glmoritz/labsc-radioenge-bluepill/output/lora-bluepill-sch.pdf

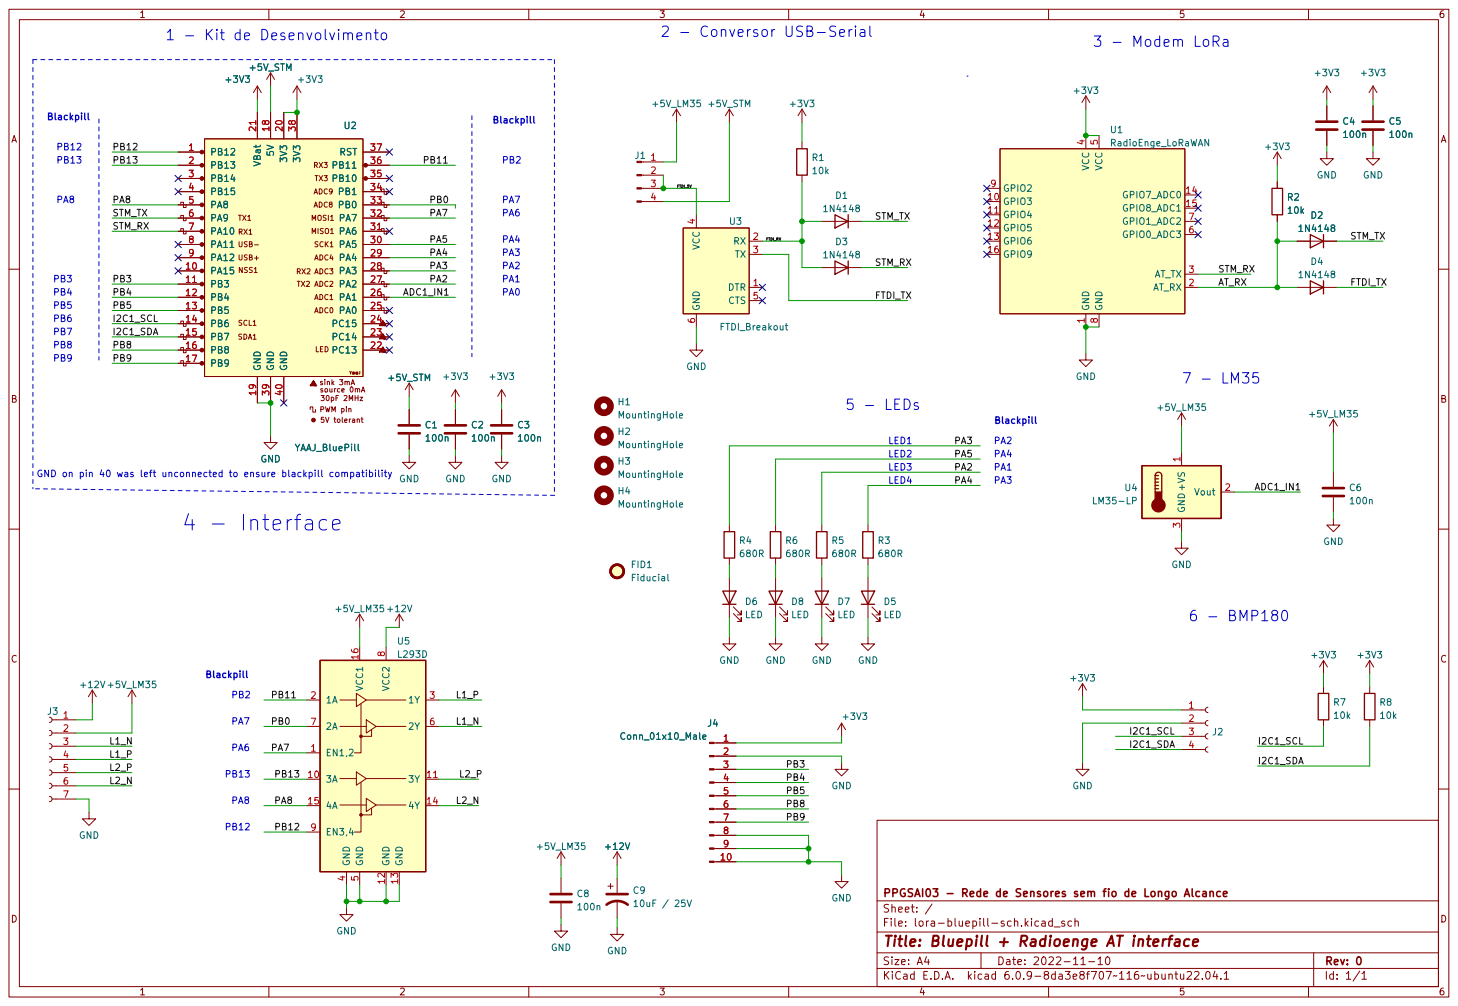
[picture p1: page 1]

LED4 PA8 GND on pin 40 was left unconnected to ensure blackpill compatibility

File: lora-bluepill-sch.kicad_sch Sheet: / PPGSAI03 - Rede de Sensores sem fio de Longo Alcance GND

Id: 1/1 Title: Bluepill + Radioenge AT interface
