glmoritz/labsc-radioenge-bluepill/output/lora-bluepill-sch-removed.pdf

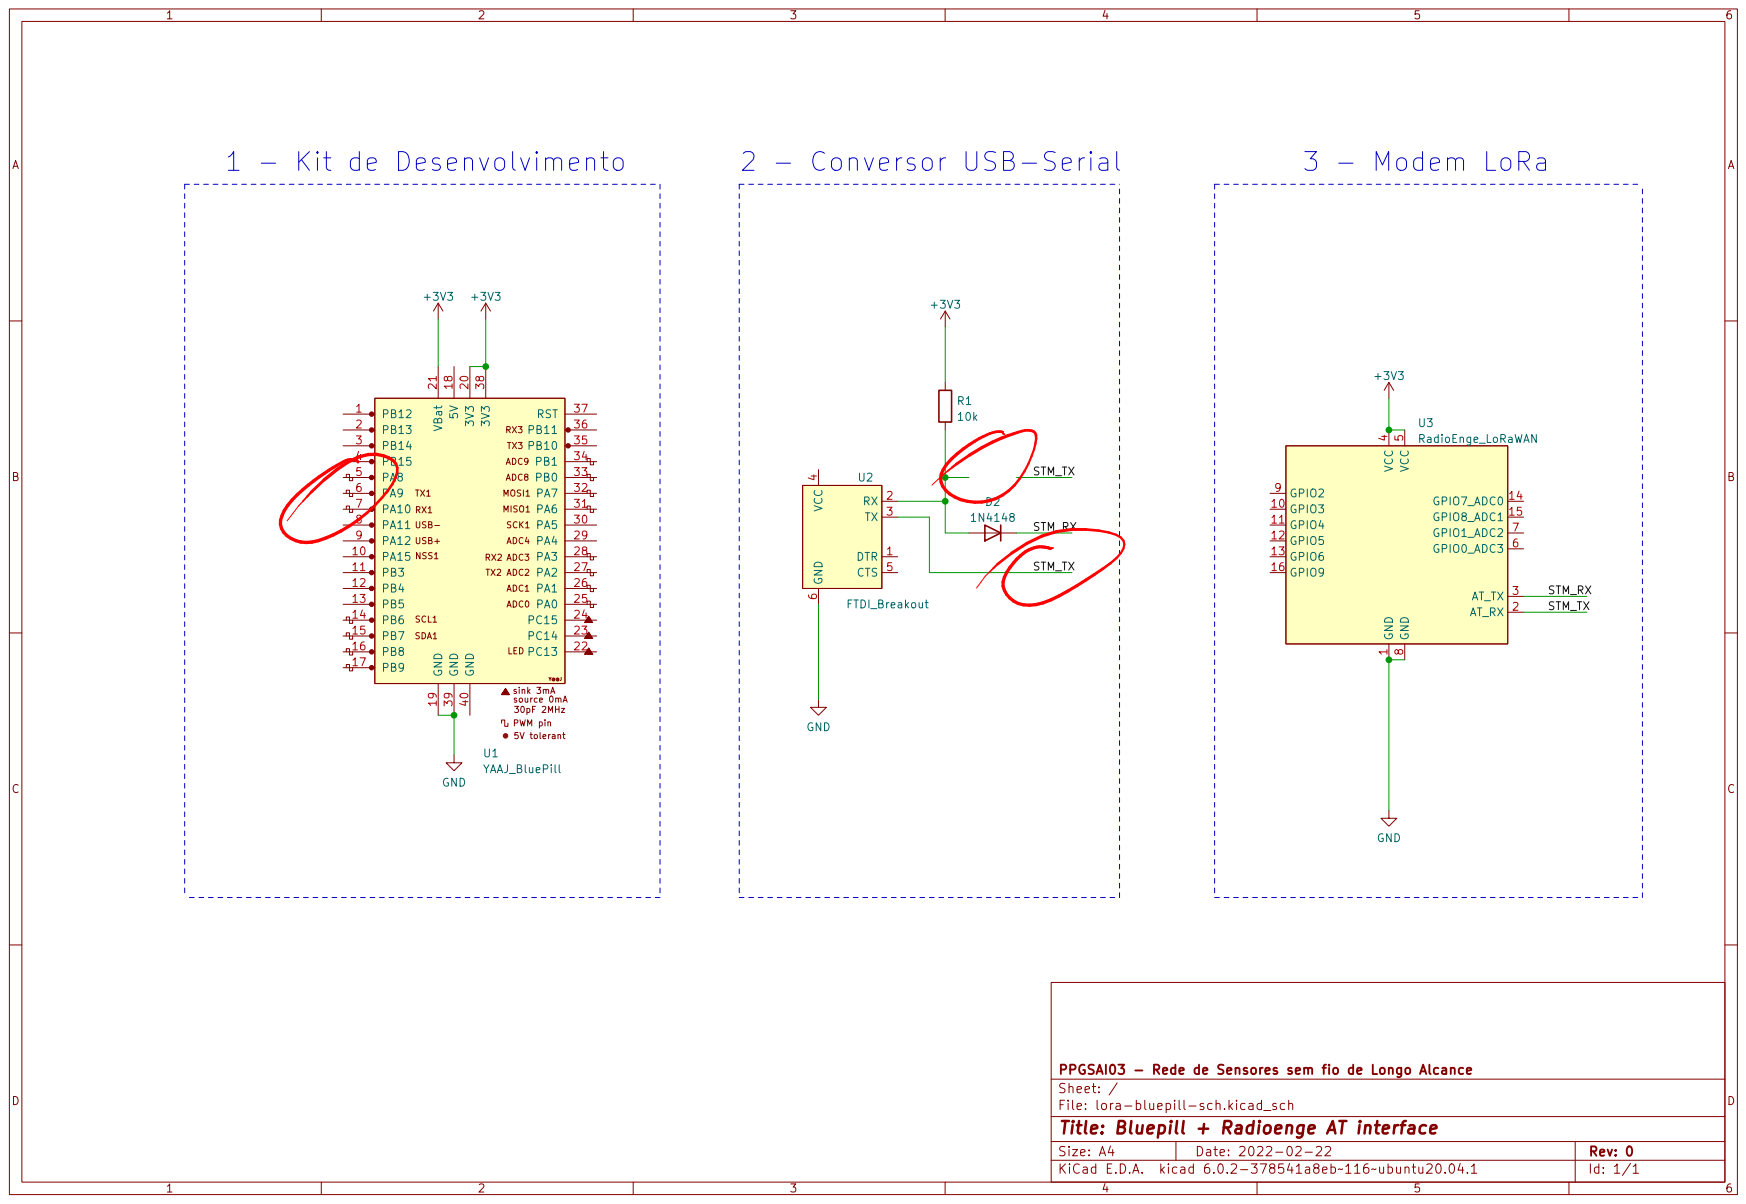
[picture p2: page 1]
