glmoritz/labsc-radioenge-bluepill/lora-bluepill-sch.kicad_pcb

## KiCad design lora-bluepill-sch.kicad_pcb (2026-08-04)

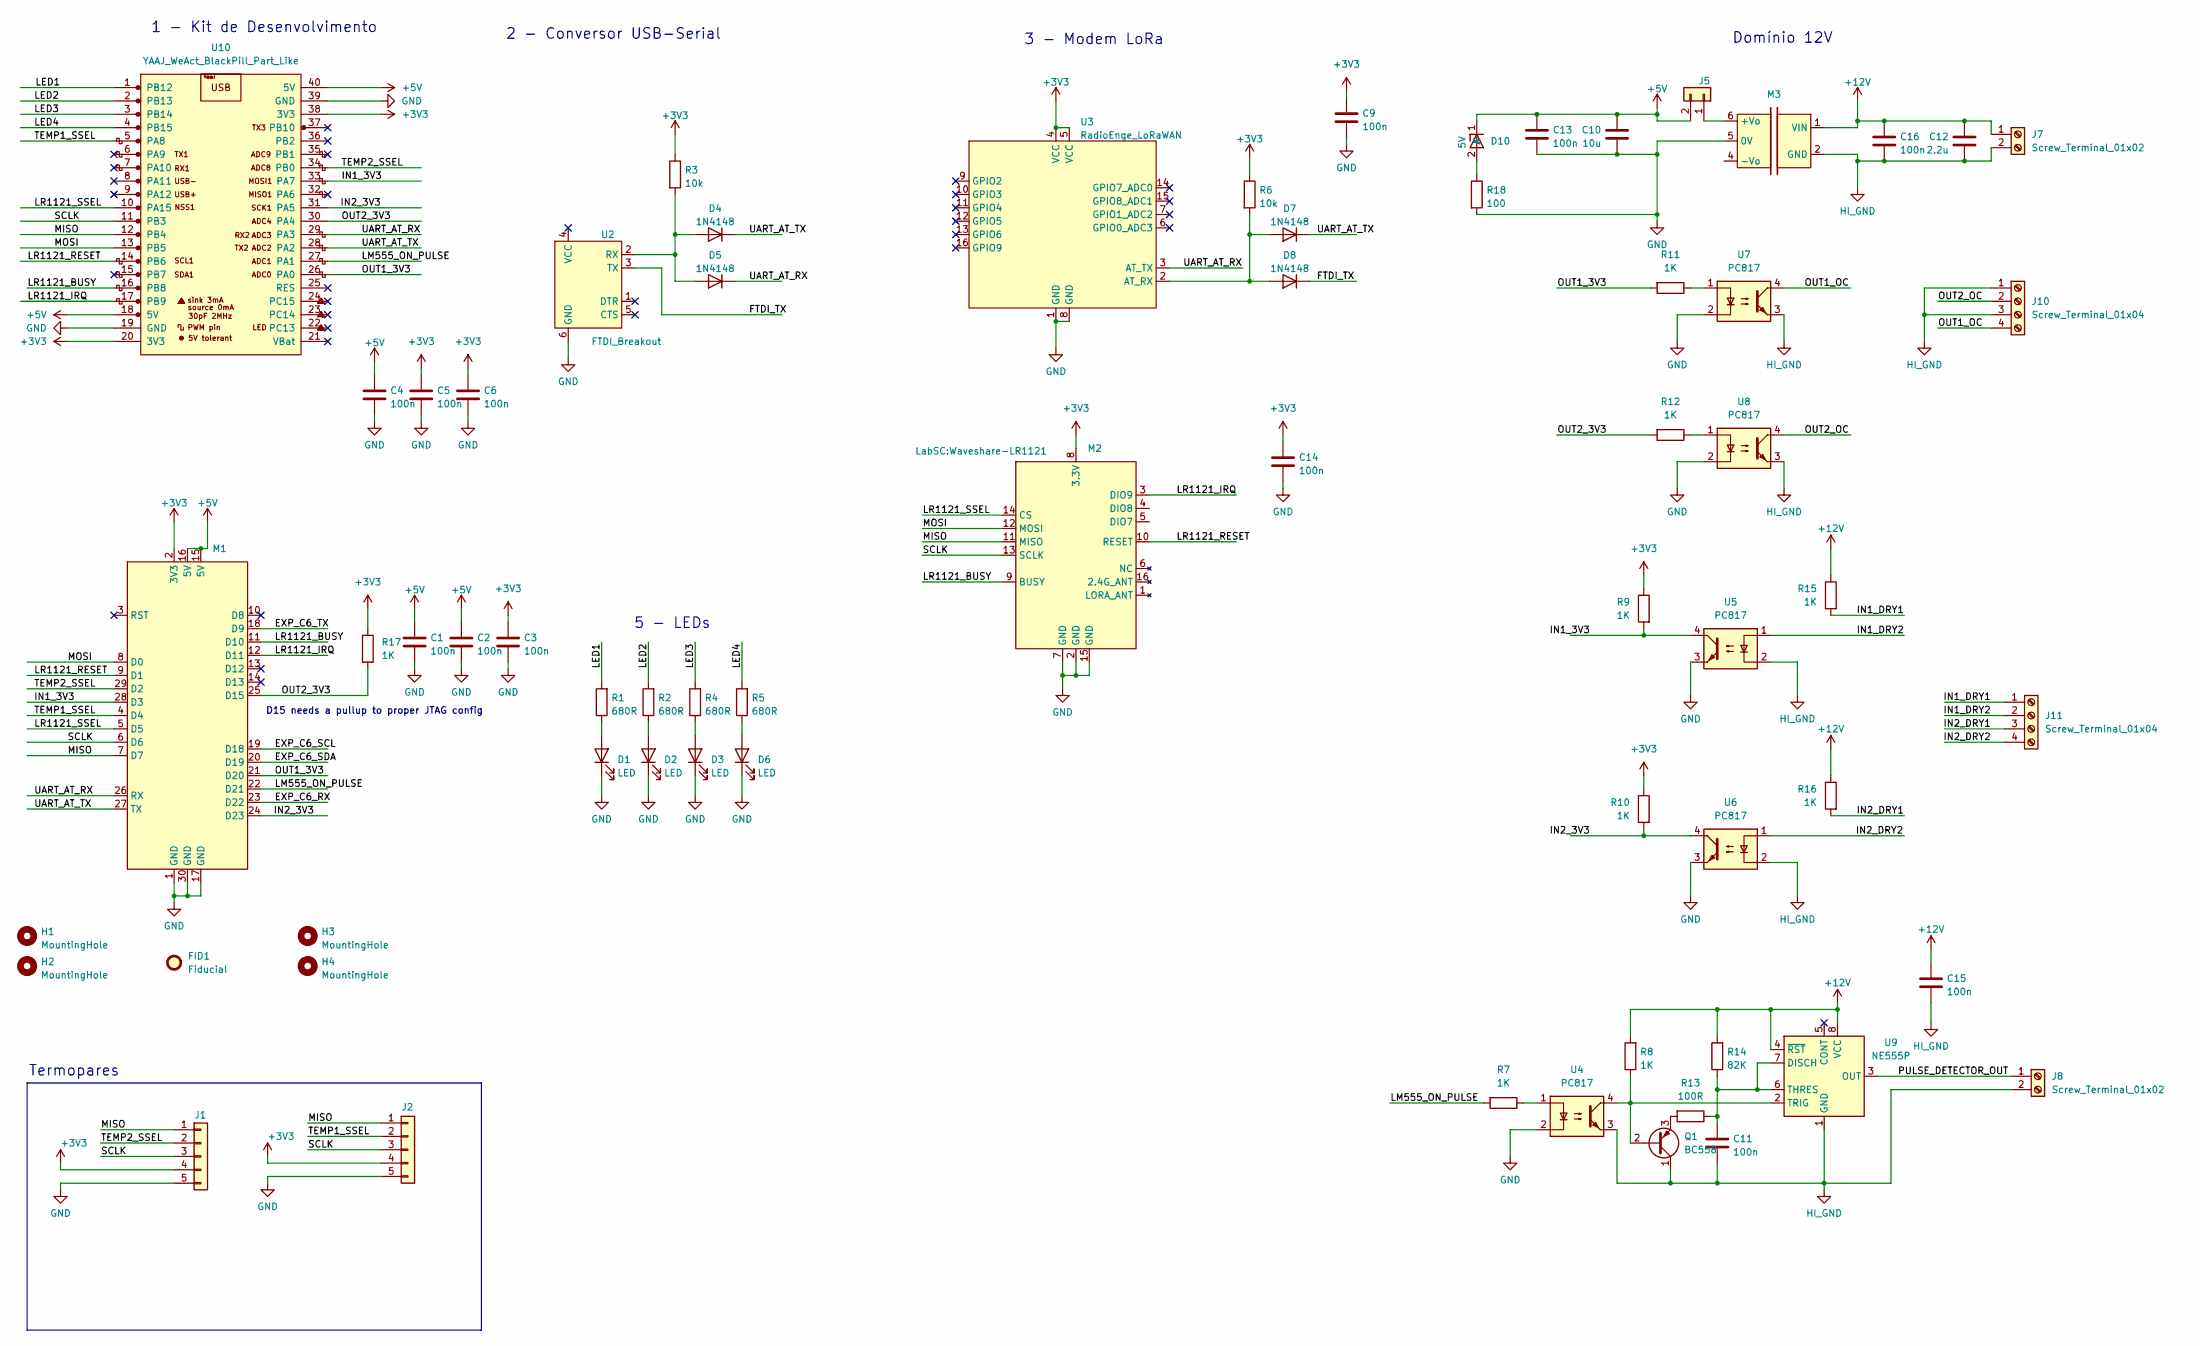
[picture p3: schematic lora-bluepill-sch.kicad_sch, Blackpill/ESP32C6 + Radioenge AT interface + LR1121]

Parts:
C1, C2, C3, C4, C5, C6, C9, C11, C13, C14, C15, C16: 100n; C_Disc_D6.0mm_W4.4mm_P5.00mm
C10: 10u; CP_Radial_D5.0mm_P2.50mm
C12: 2.2u; CP_Radial_D5.0mm_P2.50mm
D1, D2, D3, D6: LED; LED_D3.0mm
D4, D5, D7, D8: 1N4148; D_DO-35_SOD27_P7.62mm_Horizontal
D10: 5V; D_DO-35_SOD27_P7.62mm_Horizontal
FID1: Fiducial; labsc-logo
H1, H2, H3, H4: MountingHole; MountingHole_2.2mm_M2_DIN965
J1, J2: Conn_01x05; PinHeader_1x05_P2.54mm_Horizontal
J5: Conn_01x02; PinHeader_1x02_P2.54mm_Vertical
J7, J8: Screw_Terminal_01x02; HANDSON_KF301-2P
J10, J11: Screw_Terminal_01x04; HANDSON_KF301-4P
M1: ESP32C6-Minimal
M2: Waveshare-LR1121
M3: A1205S-2W
Q1: BC558; TO-92_Inline
R1, R2, R4, R5: 680R; R_Axial_DIN0204_L3.6mm_D1.6mm_P7.62mm_Horizontal
R3, R6: 10k; R_Axial_DIN0204_L3.6mm_D1.6mm_P7.62mm_Horizontal
R7, R8, R9, R10, R11, R12, R15, R16, R17: 1K; R_Axial_DIN0204_L3.6mm_D1.6mm_P7.62mm_Horizontal
R13: 100R; R_Axial_DIN0204_L3.6mm_D1.6mm_P7.62mm_Horizontal
R14: 82K; R_Axial_DIN0204_L3.6mm_D1.6mm_P7.62mm_Horizontal
R18: 100; R_Axial_DIN0204_L3.6mm_D1.6mm_P7.62mm_Horizontal
U2: FTDI_Breakout; PinSocket_1x06_P2.54mm_Vertical
U3: RadioEnge_LoRaWAN; LoRaModuleRadioenge
U4, U5, U6, U7, U8: PC817; DIP-4_W7.62mm
U9: NE555P; DIP-8_W7.62mm
U10: YAAJ_WeAct_BlackPill_Part_Like; YAAJ_WeAct_BlackPill_2

Connections:
+3V3: C3.1, C5.1, C6.1, C9.1, C14.1, J1.4, J2.4, M1.2 (3V3), M2.8 (3.3V), R3.1, R6.1, R9.1, R10.1, R17.1, U3.4 (VCC), U3.5 (VCC), U10.20 (3V3), U10.38 (3V3)
+5V: C1.1, C2.1, C4.1, C10.1, C13.1, D10.1 (K), J5.2, M1.15 (5V), M1.16 (5V), U10.18 (5V), U10.40 (5V)
+12V: C12.1, C15.1, C16.1, J7.1, M3.1 (VIN), R8.2, R14.2, R15.1, R16.1, U9.4 (~RST), U9.8 (VCC)
/EXP_C6_RX: M1.23 (D22)
/EXP_C6_SCL: M1.19 (D18)
/EXP_C6_SDA: M1.20 (D19)
/EXP_C6_TX: M1.18 (D9)
/FTDI_TX: D8.1 (K), U2.3 (TX)
/IN1_3V3: M1.28 (D3), R9.2, U5.4, U10.33 (PA7)
/IN1_DRY1: J11.1, R15.2
/IN1_DRY2: J11.2, U5.1
/IN2_3V3: M1.24 (D23), R10.2, U6.4, U10.31 (PA5)
/IN2_DRY1: J11.3, R16.2
/IN2_DRY2: J11.4, U6.1
/LED1: R1.2, U10.1 (PB12)
/LED2: R2.2, U10.2 (PB13)
/LED3: R4.2, U10.3 (PB14)
/LED4: R5.2, U10.4 (PB15)
/LM555_ON_PULSE: M1.22 (D21), R7.2, U10.27 (PA1)
/LR1121_BUSY: M1.11 (D10), M2.9 (BUSY), U10.16 (PB8)
/LR1121_IRQ: M1.12 (D11), M2.3 (DIO9), U10.17 (PB9)
/LR1121_RESET: M1.9 (D1), M2.10 (RESET), U10.14 (PB6)
/LR1121_SSEL: M1.5 (D5), M2.14 (CS), U10.10 (PA15)
/MISO: J1.1, J2.1, M1.7 (D7), M2.11 (MISO), U10.12 (PB4)
/MOSI: M1.8 (D0), M2.12 (MOSI), U10.13 (PB5)
/OUT1_3V3: M1.21 (D20), R11.2, U10.26 (PA0)
/OUT1_OC: J10.4, U7.4
/OUT2_3V3: M1.25 (D15), R12.2, R17.2, U10.30 (PA4)
/OUT2_OC: J10.2, U8.4
/PULSE_DETECTOR_OUT: J8.1, U9.3 (OUT)
/SCLK: J1.3, J2.3, M1.6 (D6), M2.13 (SCLK), U10.11 (PB3)
/TEMP1_SSEL: J2.2, M1.4 (D4), U10.5 (PA8)
/TEMP2_SSEL: J1.2, M1.29 (D2), U10.34 (PB0)
/UART_AT_RX: D5.1 (K), M1.26 (RX), U3.3 (AT_TX), U10.29 (PA3)
/UART_AT_TX: D4.1 (K), D7.1 (K), M1.27 (TX), U10.28 (PA2)
GND: C1.2, C2.2, C3.2, C4.2, C5.2, C6.2, C9.2, C10.2, C13.2, C14.2, D1.1 (K), D2.1 (K), D3.1 (K), D6.1 (K), J1.5, J2.5, M1.1 (GND), M1.17 (GND), M1.30 (GND), M2.2 (GND), M2.7 (GND), M2.15 (GND), M3.5 (0V), R18.2, U2.6 (GND), U3.1 (GND), U3.8 (GND), U4.2, U5.3, U6.3, U7.2, U8.2, U10.19 (GND), U10.39 (GND)
HI_GND: C11.2, C12.2, C15.2, C16.2, J7.2, J8.2, J10.1, J10.3, M3.2 (GND), Q1.1 (C), U4.3, U5.2, U6.2, U7.3, U8.3, U9.1 (GND)
unnamed: D1.2 (A), R1.1
unnamed: D2.2 (A), R2.1
unnamed: D3.2 (A), R4.1
unnamed: D4.2 (A), D5.2 (A), R3.2, U2.2 (RX)
unnamed: D6.2 (A), R5.1
unnamed: D7.2 (A), D8.2 (A), R6.2, U3.2 (AT_RX)
unnamed: D10.2 (A), R18.1
unnamed: J5.1, M3.6 (+Vo)
unnamed: Q1.2 (B), R8.1, U4.4, U9.2 (TRIG)
unnamed: Q1.3 (E), R13.2
unnamed: R7.1, U4.1
unnamed: R11.1, U7.1
unnamed: R12.1, U8.1
unnamed: C11.1, R13.1, R14.1, U9.6 (THRES), U9.7 (DISCH)

Notes on the sheet:
5 - LEDs
3 - Modem LoRa
Domínio 12V
Termopares
2 - Conversor USB-Serial
1 - Kit de Desenvolvimento
D15 needs a pullup to proper JTAG config

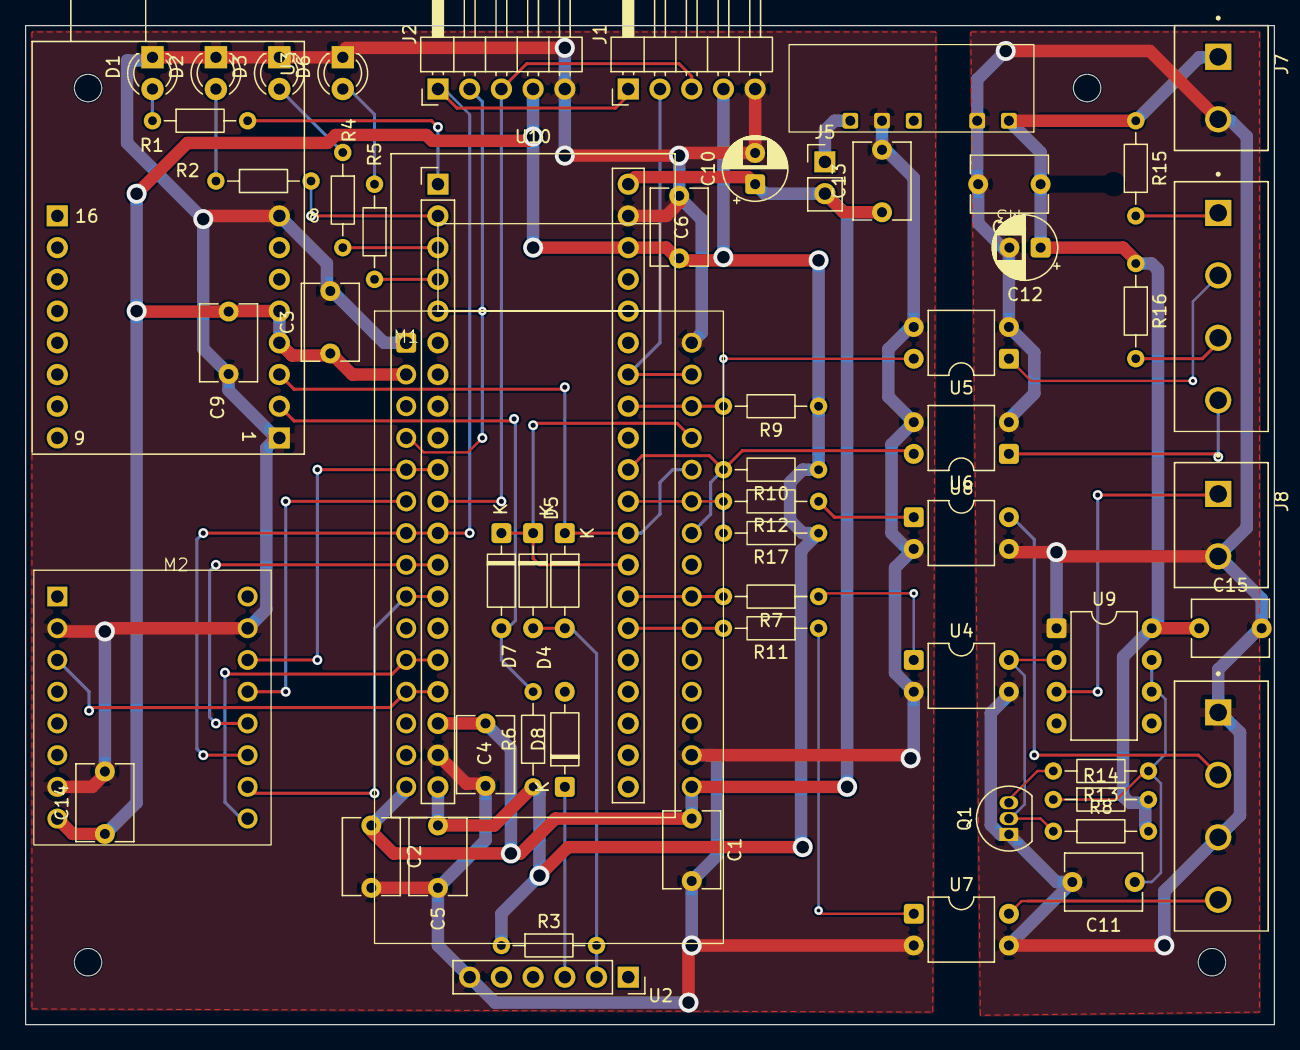
[picture p4: board lora-bluepill-sch.kicad_pcb from above]

Board: 2 copper layers, 100.0 x 80.0 mm, 64 parts (1 on the bottom side), 46 nets.
