glmoritz/labsc-radioenge-bluepill/(commit log)

2022-11-29 First Version
    [lora-bluepill-sch-B_Cu.gbr, lora-bluepill-sch-B_Mask.gbr, lora-bluepill-sch-Edge_Cuts.gbr, lora-bluepill-sch-F_Cu.gbr, lora-bluepill-sch-F_Mask.gbr, lora-bluepill-sch-F_Silkscreen.gbr, lora-bluepill-sch-NPTH.drl, lora-bluepill-sch-PTH.drl]
2022-12-01 Version sent to Fabrication
    [lora-bluepill-sch-B_Cu.gbr, lora-bluepill-sch-B_Mask.gbr, lora-bluepill-sch-B_Silkscreen.gbr, lora-bluepill-sch-Edge_Cuts.gbr, lora-bluepill-sch-F_Cu.gbr, lora-bluepill-sch-F_Silkscreen.gbr, lora-bluepill-sch-NPTH.drl, lora-bluepill-sch-PTH.drl]
2026-07-20 Make project self-contained with vendored symbol/footprint libraries
    Vendor every symbol and footprint the design uses into project-local
    libraries so the project no longer depends on external/global library
    tables (which broke on the KiCad 9->10 upgrade: standard libs moved to
    .kicad_symdir and the env var was renamed).
    Symbols (symbols/):
    - Custom: LabSC, YAAJ_BlackPill, Custom_Symbols
    - Standard subset extracted from each schematic's embedded cache so the
    exact placed symbols (and original names, e.g. Conn_01x04_Male) are
    preserved without editing the design: Connector, Device, Diode,
    Mechanical, power, Sensor_Temperature
    - Normalized to KiCad 10.0.4 native format (version 20251024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
    [lora-bluepill-sch-ftdi-input.kicad_sch]
2026-07-21 Continue design work: WeAct BlackPill footprint, screw connectors
    Vendor YAAJ_WeAct_BlackPill_2 footprint locally (was pulled in via
    Kicad-STM32 submodule path) to keep the project self-contained, and
    add the Screw01x02/Screw01x04 connectors used for the new module
    variant. Includes accompanying schematic/PCB/project updates.
    [lora-bluepill-sch.kicad_pcb, lora-bluepill-sch.kicad_sch]
2026-07-21 add footprints, wip
    [lora-bluepill-sch.kicad_pcb, lora-bluepill-sch.kicad_sch]
2026-07-22 WIP: schematic/PCB progress, screw terminals, ESP32-C6 reference
    Design work in progress on the LoRa carrier:
    - schematic and PCB updates
    - HANDSON KF301-2P / KF301-4P screw terminal footprints
    - Custom_Symbols.kicad_sym
    - Connector.kicad_sym additions, fp-lib-table / sym-lib-table updates
    - Waveshare-LR1121 footprint tweak
    - nanoESP32C6.pdf: module reference schematic. Confirms the onboard LED is
    an addressable RGB (WS2812-type) driven from GPIO8, not a plain GPIO LED.
    Bumps the Kicad-STM32 submodule to 244753d, which adds the two BlackPill
    symbols that were sitting untracked in the submodule working tree.
    [lora-bluepill-sch.kicad_pcb, lora-bluepill-sch.kicad_sch]
2026-07-22 placement evolution
    [lora-bluepill-sch.kicad_pcb, lora-bluepill-sch.kicad_sch]
2026-08-04 board finished, but not checked
    [WatchDogPowerSource.kicad_pcb, WatchDogPowerSource.kicad_sch, lora-bluepill-sch.kicad_pcb, lora-bluepill-sch.kicad_sch]
